CiphemonJY/muse-gadget-case-esp32-s3-touch-lcd-1.46b/stl/tpu_mic_gasket.stl

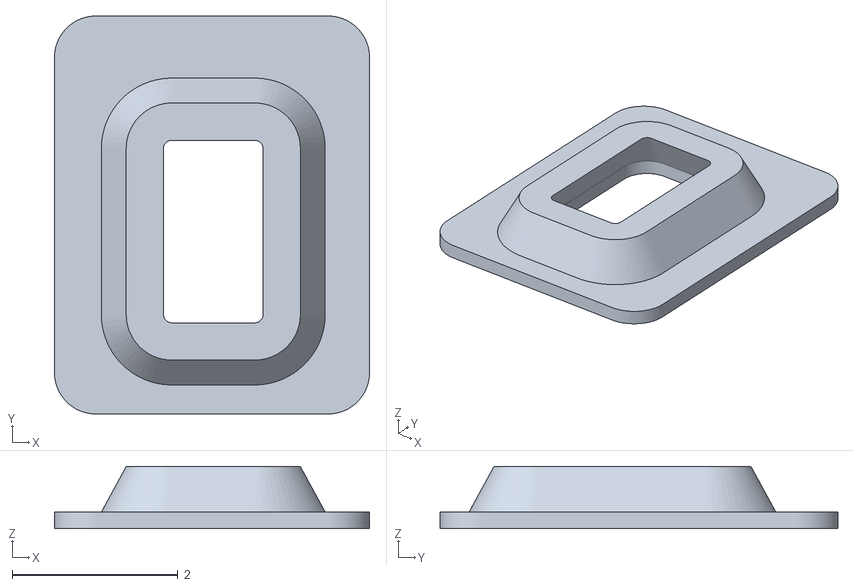
[picture p3: CAD file, 2026-10-20]
stl/tpu_mic_gasket.stl
3.80 x 4.80 x 0.75
