CiphemonJY/muse-gadget-case-esp32-s3-touch-lcd-1.46b/stl/back_plate.stl

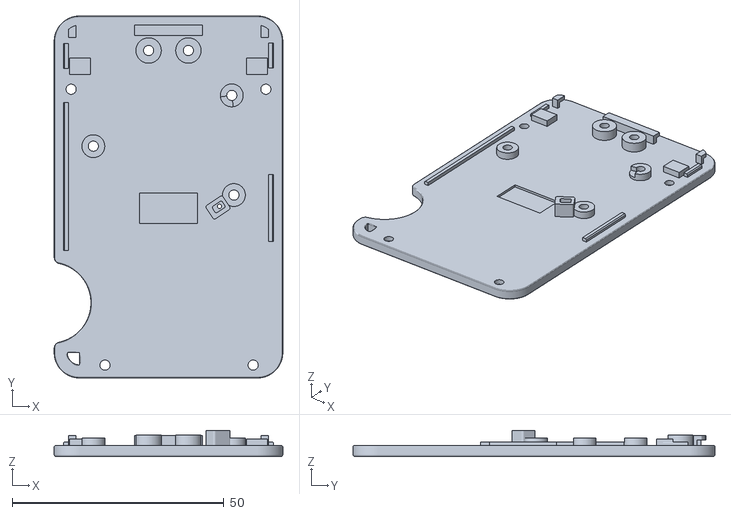
[picture p4: CAD file, 2026-10-20]
stl/back_plate.stl
54.0 x 85.5 x 6.20
