CiphemonJY/muse-gadget-case-esp32-s3-touch-lcd-1.46b/stl/front_case.stl

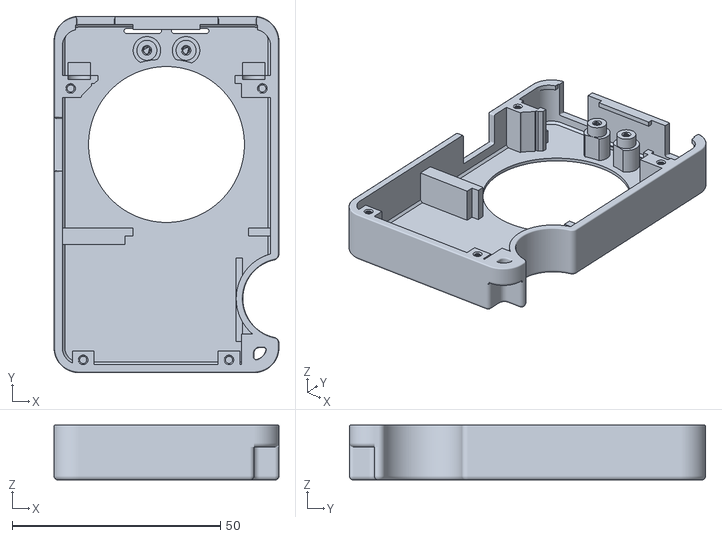
[picture p5: CAD file, 2026-10-20]
stl/front_case.stl
54.0 x 85.5 x 13.2
