CiphemonJY/muse-gadget-case-esp32-s3-touch-lcd-1.46b/stl/trigger_boot.stl

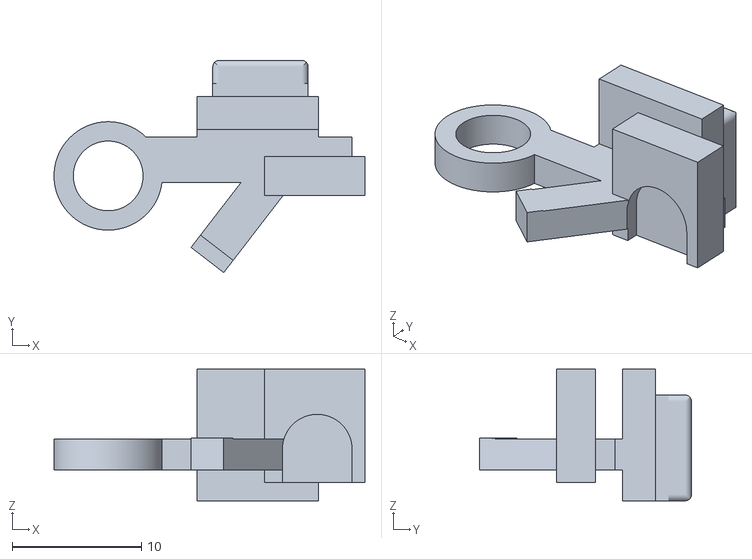
[picture p6: CAD file, 2026-10-20]
stl/trigger_boot.stl
24.1 x 16.4 x 10.2
