CiphemonJY/muse-gadget-case-esp32-s3-touch-lcd-1.46b/stl/fit_gauge_display_pocket.stl

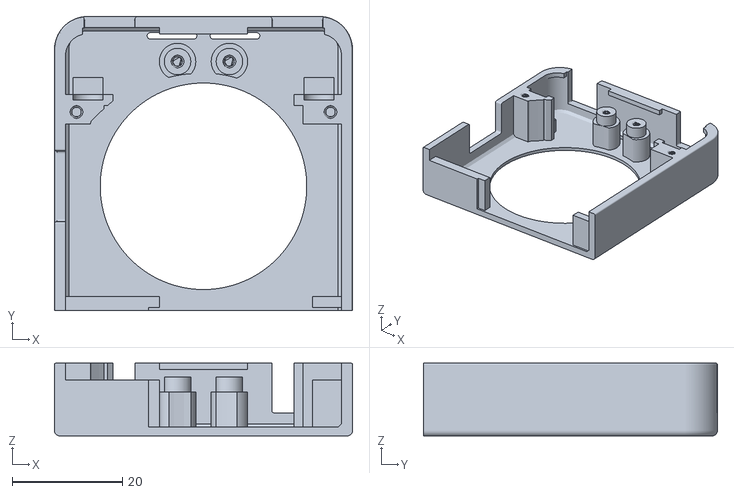
[picture p7: CAD file, 2026-10-20]
stl/fit_gauge_display_pocket.stl
54.0 x 53.2 x 13.2
