CiphemonJY/muse-gadget-case-esp32-s3-touch-lcd-1.46b/(list of files, cad)

Other CAD files:
stl/trigger_pwr.stl
