CiphemonJY/muse-gadget-case-esp32-s3-touch-lcd-1.46b/(commit log)

2026-10-20 Muse Gadget case for the Waveshare ESP32-S3-Touch-LCD-1.46B (v10s)
    Resin-printed, bank-card-sized case for a Muse Gadget SDK device on the
    Waveshare ESP32-S3-Touch-LCD-1.46B: print-ready STLs (front case, back
    plate, PWR/BOOT triggers, display fit gauge), README with BOM, print and
    assembly guide, renders. CC BY-NC-SA 4.0.
    [back_plate.stl, fit_gauge_display_pocket.stl, front_case.stl, trigger_boot.stl, trigger_pwr.stl]
2026-10-20 Add optional printable TPU mic gasket
    stl/tpu_mic_gasket.stl: a lip seal (0.2 mm base on the mic collar, 0.45 mm
    inward-leaning lip that flexes onto the mic lid, ~5 N) instead of a flat ring,
    which in TPU 95A would press ~70 N into the PCB. README: when the gasket is
    needed, TPU print settings, assembly step.
    [tpu_mic_gasket.stl]
2026-10-20 README: gasket fitting steps and a seal check
    Lip up, the one-way fit on the off-centre collar, glue the base only, what to do
    if the lip snags during the slide, and a record-with/without test.
